OP-Patel/cv-accelerator/docs/milestone7_static_projection.md

# Milestone 7 benchmark result

Generated: `2026-07-24T03:43:37.146349+00:00`

| Measurement | Result |
|---|---:|
| OpenCV median kernel time | 0.070253 ms |
| FPGA projected sustained frame time | 0.012288 ms |
| FPGA/OpenCV throughput ratio | 5.7172x |
| Bit-exact CRC agreement | True |
| Static 5% acceleration projection | PASS |

Kernel time, core time, transport FPS, and host CPU utilization are separate fields in the JSON/CSV.

> This is a routed-RTL projection, not a physical FPGA benchmark. The board run remains required for final acceptance.
