OP-Patel/cv-accelerator/scripts/python/run_m7_host_tests.py

#!/usr/bin/env python3
"""Run preserved M6 and all M7 host-side unit tests without hardware."""

from __future__ import annotations

import unittest
from pathlib import Path


def main() -> int:
    directory = Path(__file__).resolve().parent
    suite = unittest.defaultTestLoader.discover(str(directory), pattern="test_m[67]_*.py")
    result = unittest.TextTestRunner(verbosity=2).run(suite)
    return 0 if result.wasSuccessful() else 1


if __name__ == "__main__":
    raise SystemExit(main())
