OP-Patel/cv-accelerator/(commit log)

2026-07-11 fix uart bug, A9->D10 for TX
    [arty_a7_video.xdc]
2026-07-18 update docs, benchmarking with opencv vs sobel, write m6, example snap shots
    [m6_benchmark_results.csv]
2026-07-19 debug crc drc errors
    [m7_benchmark_results.csv]
2026-07-24 update parallelization, 32 lines
    [m7_static_projection.csv]
2026-07-25 benchmark and dashboard updates
    [m7_benchmark_results.csv]
